Industrieel-ingenieur-KUL/IOT_Project/IOT/IoT.csv

Reference | Qty | Value | DNP | Exclude from BOM | Exclude from Board | Exclude from Simulation | Exclude from Position Files | Footprint | Datasheet
C1,C2,C3,C4,C5,C7,C8,C9,C10,C11,C12,C13,C14,C15,C16 | 15 | 100n |  |  |  |  | ${EXCLUDE_FROM_POS_FILES}
C6 | 1 | 4.7u |  |  |  |  | ${EXCLUDE_FROM_POS_FILES} | RF_Converter:Balun_Johanson_1.6x0.8mm
C17,C19 | 2 | 10nF |  |  |  |  | ${EXCLUDE_FROM_POS_FILES}
C18 | 1 | 47uF/16V |  |  |  |  | ${EXCLUDE_FROM_POS_FILES} | Package_SO:SOIC-8_3.9x4.9mm_P1.27mm
C20 | 1 | 47uF/10V |  |  |  |  | ${EXCLUDE_FROM_POS_FILES} | Package_SO:SOIC-8_3.9x4.9mm_P1.27mm
C21,C22 | 2 | 22uF/50V |  |  |  |  | ${EXCLUDE_FROM_POS_FILES} | Package_SO:SOIC-8_3.9x4.9mm_P1.27mm
D1,D2,D3,D4 | 4 | LED |  |  |  |  | ${EXCLUDE_FROM_POS_FILES} | LED_SMD:LED_Cree-XHP50_3V_HighDensity
D5,D6 | 2 | SK34 |  |  |  |  | ${EXCLUDE_FROM_POS_FILES} | Package_SON:WSON-8-1EP_6x5mm_P1.27mm_EP3.4x4mm
J1 | 1 | Program header |  |  |  |  | ${EXCLUDE_FROM_POS_FILES}
J2 | 1 | Micro_SD_Card_Det2 |  |  |  |  | ${EXCLUDE_FROM_POS_FILES} |  | https://www.hirose.com/en/product/document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
J3 | 1 | USB_C_Receptacle_USB2.0_16P |  |  |  |  | ${EXCLUDE_FROM_POS_FILES} | Connector_USB:USB_C_Receptacle_Amphenol_12401948E412A | https://www.usb.org/sites/default/files/documents/usb_type-c.zip
J4,J5 | 2 | Conn_01x08_Pin |  |  |  |  | ${EXCLUDE_FROM_POS_FILES}
J6 | 1 | RS232_2 |  |  |  |  | ${EXCLUDE_FROM_POS_FILES} | Connector_Dsub:DSUB-9_Pins_Horizontal_P2.77x2.84mm_EdgePinOffset14.56mm_Housed_MountingHolesOffset15.98mm
J7 | 1 | RS232_1 |  |  |  |  | ${EXCLUDE_FROM_POS_FILES} | Connector_Dsub:DSUB-9_Pins_Horizontal_P2.77x2.84mm_EdgePinOffset14.56mm_Housed_MountingHolesOffset15.98mm
J8 | 1 | 24V |  |  |  |  | ${EXCLUDE_FROM_POS_FILES} | TerminalBlock_Philmore:TerminalBlock_Philmore_TB132_1x02_P5.00mm_Horizontal
J9 | 1 | 12V |  |  |  |  | ${EXCLUDE_FROM_POS_FILES} | TerminalBlock_Philmore:TerminalBlock_Philmore_TB132_1x02_P5.00mm_Horizontal
J10 | 1 | 5V |  |  |  |  | ${EXCLUDE_FROM_POS_FILES} | TerminalBlock_Philmore:TerminalBlock_Philmore_TB132_1x02_P5.00mm_Horizontal
J11 | 1 | 3V3 |  |  |  |  | ${EXCLUDE_FROM_POS_FILES} | TerminalBlock_Philmore:TerminalBlock_Philmore_TB132_1x02_P5.00mm_Horizontal
L1 | 1 | 22uH 2A |  |  |  |  | ${EXCLUDE_FROM_POS_FILES}
L2 | 1 | 15uH 3A |  |  |  |  | ${EXCLUDE_FROM_POS_FILES}
R1,R9,R11 | 3 | 10k |  |  |  |  | ${EXCLUDE_FROM_POS_FILES}
R2,R3,R4,R5 | 4 | 1k |  |  |  |  | ${EXCLUDE_FROM_POS_FILES}
R6,R7 | 2 | 5.1k |  |  |  |  | ${EXCLUDE_FROM_POS_FILES}
R8 | 1 | 88.7k |  |  |  |  | ${EXCLUDE_FROM_POS_FILES}
R10 | 1 | 30.9k |  |  |  |  | ${EXCLUDE_FROM_POS_FILES}
SW1,SW2 | 2 | SW_Push |  |  |  |  | ${EXCLUDE_FROM_POS_FILES} | Package_SO:TSSOP-20_4.4x6.5mm_P0.65mm
U1 | 1 | STM32F401RETx |  |  |  |  | ${EXCLUDE_FROM_POS_FILES} | Package_QFP:LQFP-64_10x10mm_P0.5mm | https://www.st.com/resource/en/datasheet/stm32f401re.pdf
U2,U3 | 2 | MAX3232 |  |  |  |  | ${EXCLUDE_FROM_POS_FILES} |  | https://datasheets.maximintegrated.com/en/ds/MAX3222-MAX3241.pdf
U4,U5 | 2 | TPS5430DDA |  |  |  |  | ${EXCLUDE_FROM_POS_FILES} | Package_SO:TI_SO-PowerPAD-8_ThermalVias | http://www.ti.com/lit/ds/symlink/tps5430.pdf
