Industrieel-ingenieur-KUL/IOT_Project/IOT/pdf.pdf

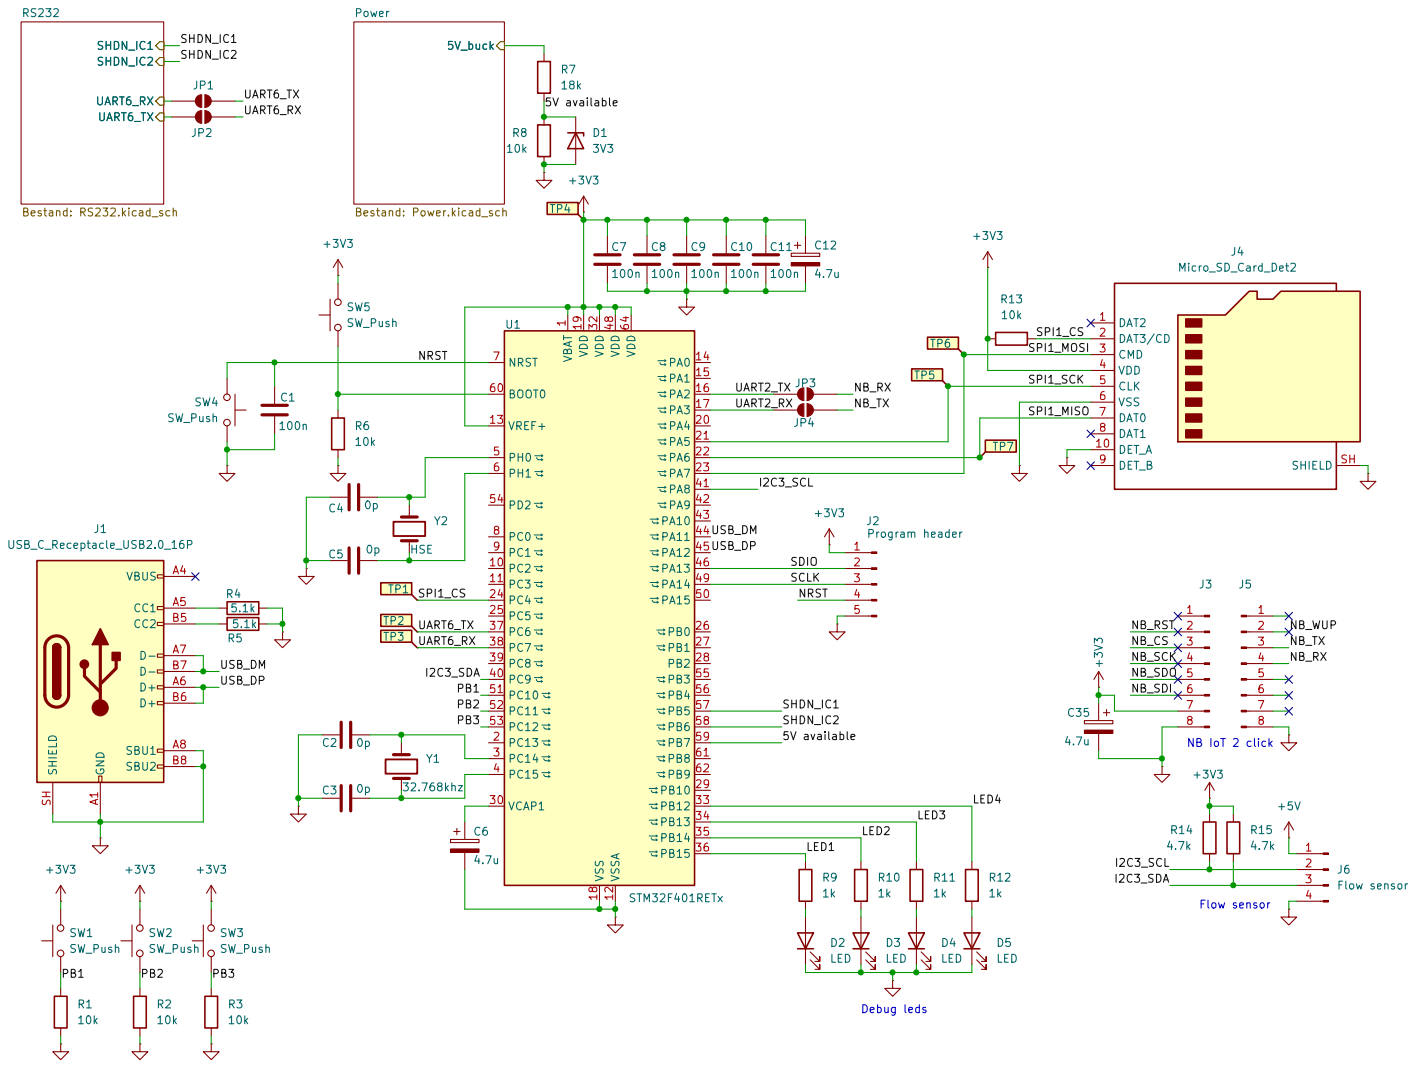
[picture p1: page 1]

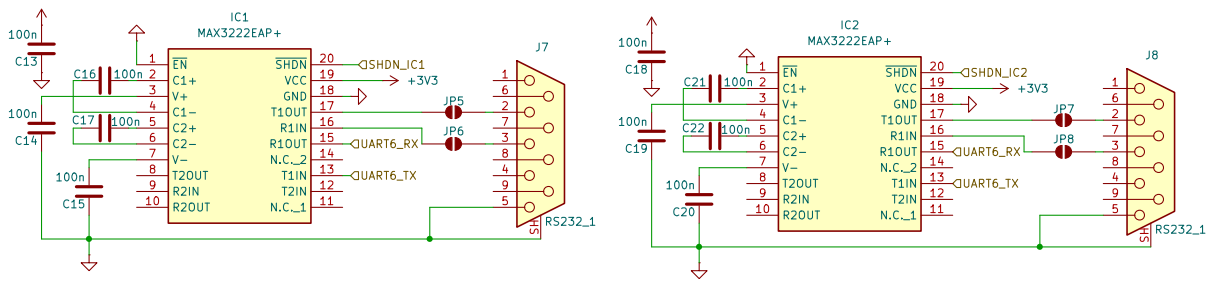
[picture p2: page 2]

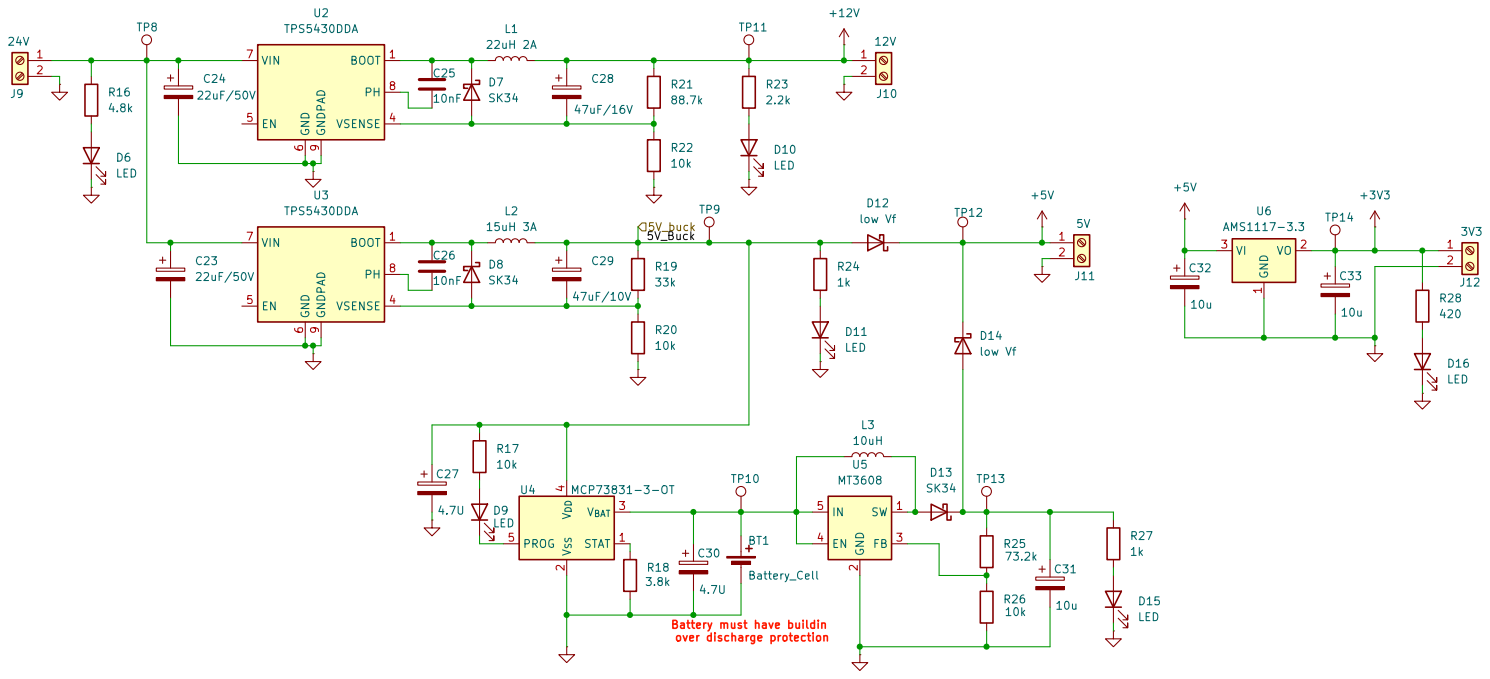
[picture p3: page 3]
