Industrieel-ingenieur-KUL/IOT_Project/IOT/IoT.kicad_pcb

## KiCad design IOT/IoT.kicad_pcb (2026-10-27)

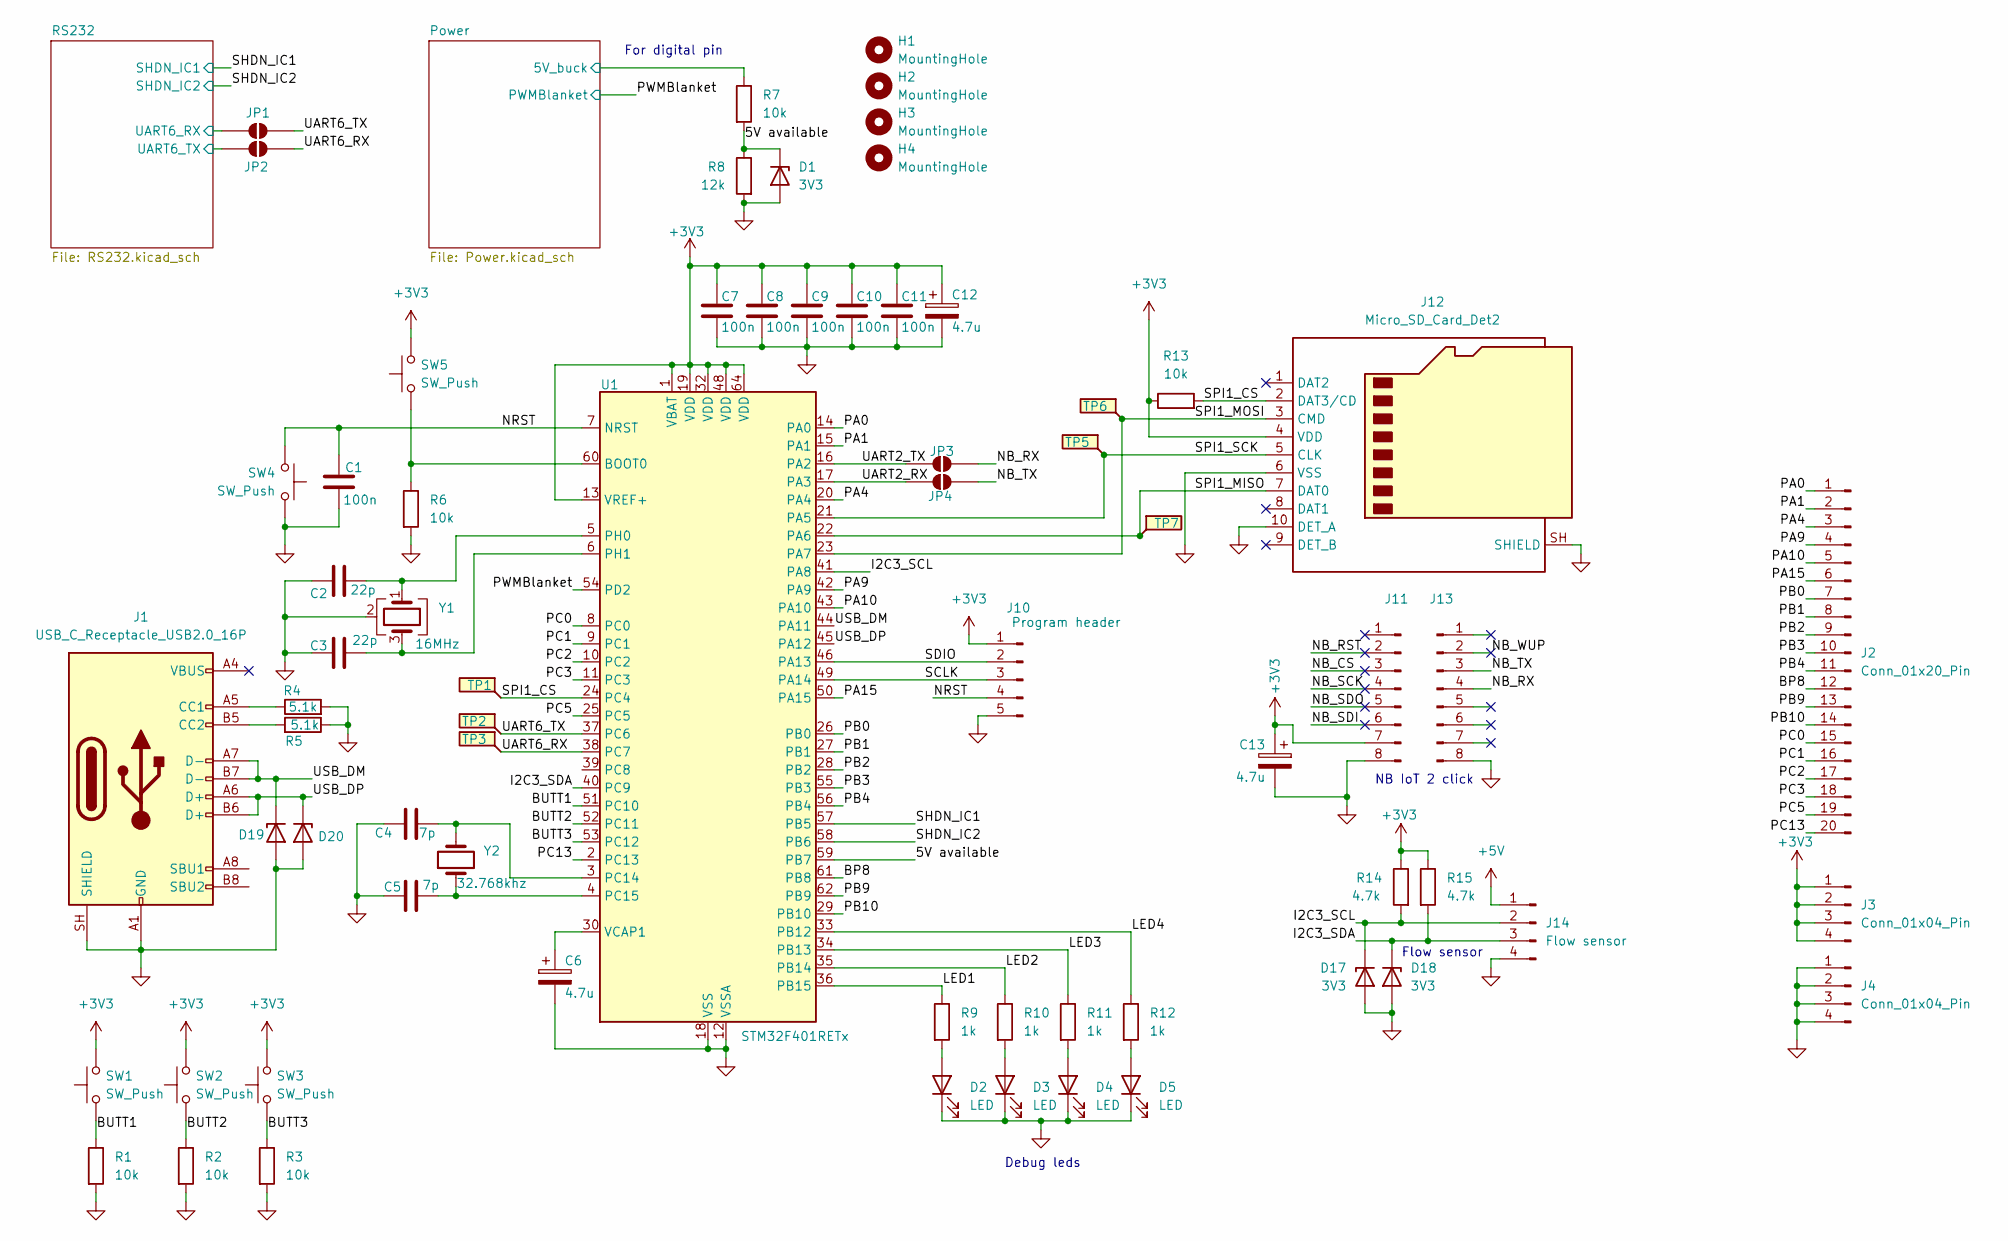
[picture p4: schematic IoT.kicad_sch]

Parts:
C1, C7, C8, C9, C10, C11: 100n; C_0805_2012Metric_Pad1.18x1.45mm_HandSolder
C2, C3: 22p; C_0805_2012Metric_Pad1.18x1.45mm_HandSolder
C4, C5: 7p; C_0805_2012Metric_Pad1.18x1.45mm_HandSolder
C6, C12, C13: 4.7u; C_0805_2012Metric_Pad1.18x1.45mm_HandSolder
D1, D17, D18: 3V3; Nexperia_CFP3_SOD-123W
D2, D3, D4, D5: LED; D_0805_2012Metric_Pad1.15x1.40mm_HandSolder
D19, D20: PTVS5V0Z1USK; D_1206_3216Metric_Pad1.42x1.75mm_HandSolder
H1, H2, H3, H4: MountingHole; MountingHole_5.3mm_M5_ISO14580
J1: USB_C_Receptacle_USB2.0_16P; USB_C_Receptacle_G-Switch_GT-USB-7010ASV
J2: Conn_01x20_Pin; PinHeader_1x20_P2.54mm_Vertical
J3, J4: Conn_01x04_Pin; PinSocket_1x04_P2.54mm_Vertical
J10: Program header; PinSocket_1x05_P2.54mm_Vertical
J11, J13: Conn_01x08_Pin; PinSocket_1x08_P2.54mm_Vertical
J12: Micro_SD_Card_Det2; microSD_HC_Molex_104031-0811
J14: Flow sensor; PinSocket_1x04_P2.54mm_Vertical
JP1, JP2, JP3, JP4: SolderJumper_2_Open; SolderJumper-2_P1.3mm_Open_RoundedPad1.0x1.5mm
R1, R2, R3, R6, R7, R13: 10k; LED_1206_3216Metric_Pad1.42x1.75mm_HandSolder
R4, R5: 5.1k; LED_1206_3216Metric_Pad1.42x1.75mm_HandSolder
R8: 12k; LED_1206_3216Metric_Pad1.42x1.75mm_HandSolder
R9, R10, R11, R12: 1k; LED_1206_3216Metric_Pad1.42x1.75mm_HandSolder
R14, R15: 4.7k; LED_1206_3216Metric_Pad1.42x1.75mm_HandSolder
SW1, SW2, SW3, SW4, SW5: SW_Push; SW_DIP_SPSTx01_Slide_6.7x4.1mm_W6.73mm_P2.54mm_LowProfile_J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
TP1, TP2, TP3, TP5, TP6, TP7: TestPoint_Flag; Pin_D0.7mm_L6.5mm_W1.8mm_FlatFork
U1: STM32F401RETx; LQFP-64_10x10mm_P0.5mm
Y1: 16MHz; Crystal_SMD_Abracon_ABM8AIG-4Pin_3.2x2.5mm
Y2: 32.768khz; Crystal_SMD_3215-2Pin_3.2x1.5mm

Connections:
+3V3: C7.1, C8.1, C9.1, C10.1, C11.1, C12.1, C13.1, J3.1, J3.2, J3.3, J3.4, J10.1, J11.7, J12.4 (VDD), R13.1, R14.1, R15.1, SW1.2, SW2.2, SW3.2, SW5.2, U1.1 (VBAT), U1.13 (VREF+), U1.19 (VDD), U1.32 (VDD), U1.48 (VDD), U1.64 (VDD); also elsewhere on the board
+5V: J14.1; also elsewhere on the board
/5V available: D1.1 (K), R7.2, R8.1, U1.59 (PB7)
/BP8: J2.12, U1.61 (PB8)
/BUTT1: R1.1, SW1.1, U1.51 (PC10)
/BUTT2: R2.1, SW2.1, U1.52 (PC11)
/BUTT3: R3.1, SW3.1, U1.53 (PC12)
/I2C3_SCL: D17.1 (K), J14.2, R14.2, U1.41 (PA8)
/I2C3_SDA: D18.1 (K), J14.3, R15.2, U1.40 (PC9)
/LED1: R9.1, U1.36 (PB15)
/LED2: R10.1, U1.35 (PB14)
/LED3: R11.1, U1.34 (PB13)
/LED4: R12.1, U1.33 (PB12)
/NB_CS: J11.3
/NB_RST: J11.2
/NB_RX: J13.4, JP3.2 (B)
/NB_SCK: J11.4
/NB_SDI: J11.6
/NB_SDO: J11.5
/NB_TX: J13.3, JP4.2 (B)
/NB_WUP: J13.2
/NRST: C1.1, J10.4, SW4.2, U1.7 (NRST)
/PA0: J2.1, U1.14 (PA0)
/PA1: J2.2, U1.15 (PA1)
/PA4: J2.3, U1.20 (PA4)
/PA9: J2.4, U1.42 (PA9)
/PA10: J2.5, U1.43 (PA10)
/PA15: J2.6, U1.50 (PA15)
/PB0: J2.7, U1.26 (PB0)
/PB1: J2.8, U1.27 (PB1)
/PB2: J2.9, U1.28 (PB2)
/PB3: J2.10, U1.55 (PB3)
/PB4: J2.11, U1.56 (PB4)
/PB9: J2.13, U1.62 (PB9)
/PB10: J2.14, U1.29 (PB10)
/PC0: J2.15, U1.8 (PC0)
/PC1: J2.16, U1.9 (PC1)
/PC2: J2.17, U1.10 (PC2)
/PC3: J2.18, U1.11 (PC3)
/PC5: J2.19, U1.25 (PC5)
/PC13: J2.20, U1.2 (PC13)
/PWMBlanket: U1.54 (PD2); also elsewhere on the board
/Power/5V_Buck: R7.1; also elsewhere on the board
/RS232/UART6_RX: JP1.1 (A); also elsewhere on the board
/RS232/UART6_TX: JP2.1 (A); also elsewhere on the board
/SCLK: J10.3, U1.49 (PA14)
/SDIO: J10.2, U1.46 (PA13)
/SHDN_IC1: U1.57 (PB5); also elsewhere on the board
/SHDN_IC2: U1.58 (PB6); also elsewhere on the board
/SPI1_CS: J12.2 (DAT3/CD), R13.2, TP1.1 (1_1), U1.24 (PC4)
/SPI1_MISO: J12.7 (DAT0), TP7.1 (1_1), U1.22 (PA6)
/SPI1_MOSI: J12.3 (CMD), TP6.1 (1_1), U1.23 (PA7)
/SPI1_SCK: J12.5 (CLK), TP5.1 (1_1), U1.21 (PA5)
/UART2_RX: JP4.1 (A), U1.17 (PA3)
/UART2_TX: JP3.1 (A), U1.16 (PA2)
/UART6_RX: JP2.2 (B), TP3.1 (1_1), U1.38 (PC7)
/UART6_TX: JP1.2 (B), TP2.1 (1_1), U1.37 (PC6)
/USB_DM: D19.1 (K), J1.A7 (D-), J1.B7 (D-), U1.44 (PA11)
/USB_DP: D20.1 (K), J1.A6 (D+), J1.B6 (D+), U1.45 (PA12)
GND: C1.2, C2.1, C3.1, C4.1, C5.1, C6.2, C7.2, C8.2, C9.2, C10.2, C11.2, C12.2, C13.2, D1.2 (A), D2.1 (K), D3.1 (K), D4.1 (K), D5.1 (K), D17.2 (A), D18.2 (A), D19.2 (A), D20.2 (A), J1.A1 (GND), J1.A12 (GND), J1.B1 (GND), J1.B12 (GND), J1.SH (SHIELD), J4.1, J4.2, J4.3, J4.4, J10.5, J11.8, J12.6 (VSS), J12.10 (DET_A), J12.SH (SHIELD), J13.8, J14.4, R1.2, R2.2, R3.2, R4.2, R5.1, R6.2, R8.2, SW4.1, U1.12 (VSSA), U1.18 (VSS), U1.31 (VSS), U1.47 (VSS), U1.63 (VSS), Y1.2 (G), Y1.4 (G); also elsewhere on the board
unnamed: D2.2 (A), R9.2
unnamed: D3.2 (A), R10.2
unnamed: D4.2 (A), R11.2
unnamed: D5.2 (A), R12.2
unnamed: J1.A5 (CC1), R4.1
unnamed: J1.B5 (CC2), R5.2
unnamed: R6.1, SW5.1, U1.60 (BOOT0)
unnamed: C4.2, U1.3 (PC14), Y2.2
unnamed: C5.2, U1.4 (PC15), Y2.1
unnamed: C2.2, U1.5 (PH0), Y1.1
unnamed: C3.2, U1.6 (PH1), Y1.3
unnamed: C6.1, U1.30 (VCAP1)

Notes on the sheet:
Debug leds
For digital pin
Flow sensor
NB IoT 2 click

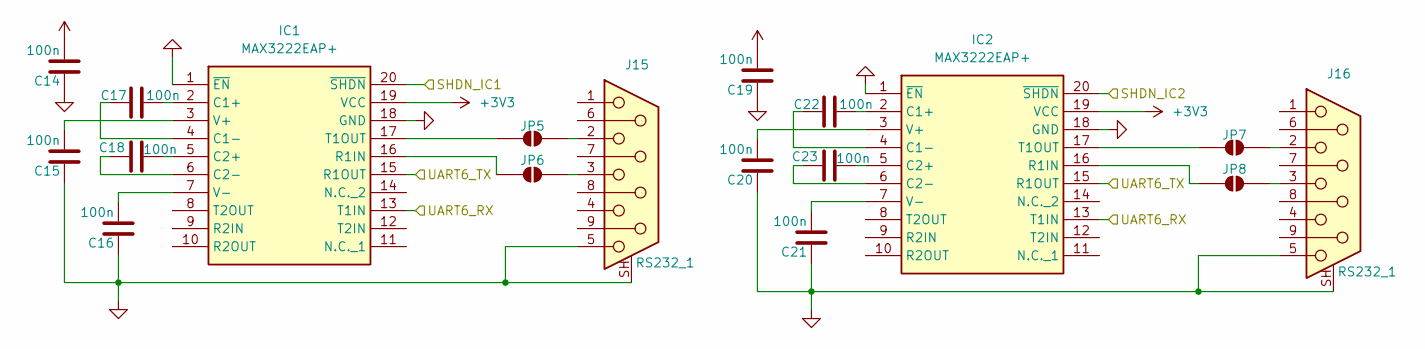
[picture p5: schematic RS232.kicad_sch]

Parts:
C14, C15, C16, C17, C18, C19, C20, C21, C22, C23: 100n; C_0805_2012Metric_Pad1.18x1.45mm_HandSolder
IC1, IC2: MAX3222EAP+; TSSOP-20_4.4x5mm_P0.4mm; Mouser Part Number 700-MAX3222EAP
J15, J16: RS232_1; DSUB-9_Pins_Horizontal_P2.77x2.84mm_EdgePinOffset14.56mm_Ho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
JP5, JP6, JP7, JP8: SolderJumper_2_Open; SolderJumper-2_P1.3mm_Open_RoundedPad1.0x1.5mm

Connections:
+3V3: C14.2, C19.2, IC1.19 (VCC), IC2.19 (VCC); also elsewhere on the board
/RS232/UART6_RX: IC1.13 (T1IN), IC2.13 (T1IN); also elsewhere on the board
/RS232/UART6_TX: IC1.15 (R1OUT), IC2.15 (R1OUT); also elsewhere on the board
/SHDN_IC1: IC1.20 (~SHDN); also elsewhere on the board
/SHDN_IC2: IC2.20 (~SHDN); also elsewhere on the board
GND: C14.1, C15.1, C16.1, C19.1, C20.1, C21.1, IC1.1 (~EN), IC1.18 (GND), IC2.1 (~EN), IC2.18 (GND), J15.5, J15.SH (PAD), J16.5, J16.SH (PAD); also elsewhere on the board
unnamed: C17.2, IC1.2 (C1+)
unnamed: C17.1, IC1.4 (C1-)
unnamed: C18.2, IC1.5 (C2+)
unnamed: C18.1, IC1.6 (C2-)
unnamed: IC1.16 (R1IN), JP6.1 (A)
unnamed: IC1.17 (T1OUT), JP5.1 (A)
unnamed: C15.2, IC1.3 (V+)
unnamed: C16.2, IC1.7 (V-)
unnamed: C22.2, IC2.2 (C1+)
unnamed: C22.1, IC2.4 (C1-)
unnamed: C23.2, IC2.5 (C2+)
unnamed: C23.1, IC2.6 (C2-)
unnamed: IC2.16 (R1IN), JP8.1 (A)
unnamed: IC2.17 (T1OUT), JP7.1 (A)
unnamed: C20.2, IC2.3 (V+)
unnamed: C21.2, IC2.7 (V-)
unnamed: J15.2, JP5.2 (B)
unnamed: J15.3, JP6.2 (B)
unnamed: J16.2, JP7.2 (B)
unnamed: J16.3, JP8.2 (B)

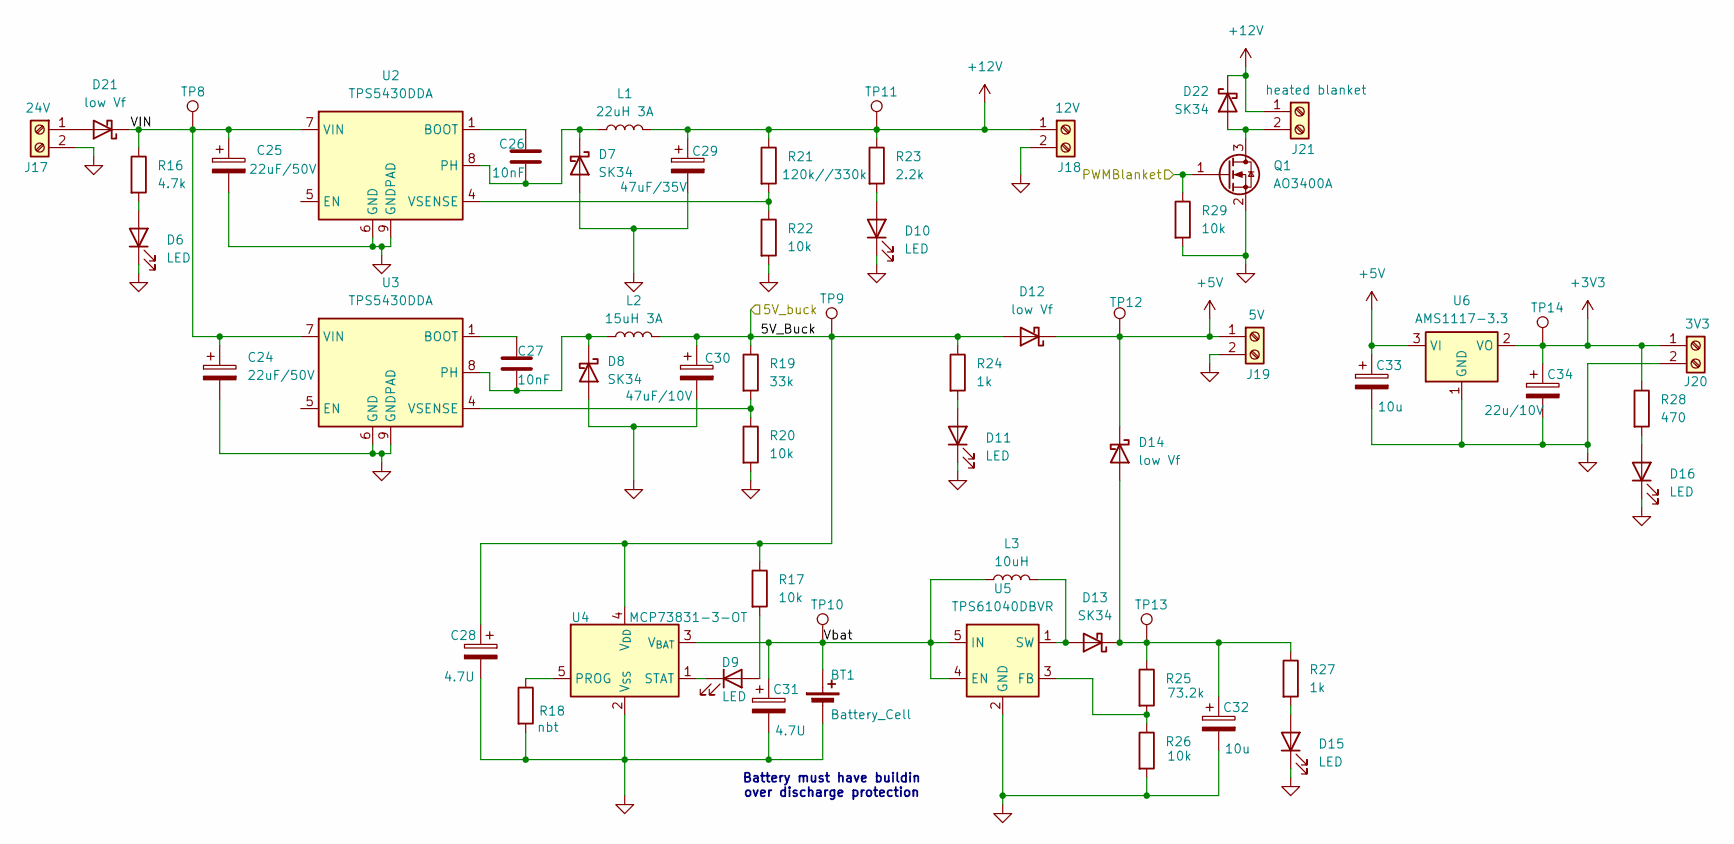
[picture p6: schematic Power.kicad_sch]

Parts:
BT1: Battery_Cell; BatteryHolder_MPD_BH-18650-PC
C24, C25: 22uF/50V; CP_Elec_5x5.4
C26, C27: 10nF; C_0805_2012Metric_Pad1.18x1.45mm_HandSolder
C28, C31: 4.7U; CP_Elec_4x5.4
C29: 47uF/35V; CP_Elec_8x10
C30: 47uF/10V; CP_Elec_8x10
C32, C33: 10u; C_0805_2012Metric_Pad1.18x1.45mm_HandSolder
C34: 22u/10V; CP_EIA-3528-12_Kemet-T_HandSolder
D6, D9, D10, D11, D15, D16: LED; D_0805_2012Metric_Pad1.15x1.40mm_HandSolder
D7, D8, D13, D22: SK34; D_SMA_Handsoldering
D12, D14, D21: low Vf; D_SMC_Handsoldering
J17: 24V; TerminalBlock_Philmore_TB132_1x02_P5.00mm_Horizontal
J18: 12V; TerminalBlock_Philmore_TB132_1x02_P5.00mm_Horizontal
J19: 5V; TerminalBlock_Philmore_TB132_1x02_P5.00mm_Horizontal
J20: 3V3; TerminalBlock_Philmore_TB132_1x02_P5.00mm_Horizontal
J21: heated blanket; TerminalBlock_Philmore_TB132_1x02_P5.00mm_Horizontal
L1: 22uH 3A; L_Wuerth_WE-PD-Typ-LS_Handsoldering
L2: 15uH 3A; L_Bourns_SRP7028A_7.3x6.6mm
L3: 10uH; L_Bourns_SRP7028A_7.3x6.6mm
Q1: AO3400A; SOT-23
R16: 4.7k; LED_1206_3216Metric_Pad1.42x1.75mm_HandSolder
R17, R20, R22, R26, R29: 10k; LED_1206_3216Metric_Pad1.42x1.75mm_HandSolder
R18: nbt; LED_1206_3216Metric_Pad1.42x1.75mm_HandSolder
R19: 33k; LED_1206_3216Metric_Pad1.42x1.75mm_HandSolder
R21: 120k//330k; LED_1206_3216Metric_Pad1.42x1.75mm_HandSolder
R23: 2.2k; LED_1206_3216Metric_Pad1.42x1.75mm_HandSolder
R24, R27: 1k; LED_1206_3216Metric_Pad1.42x1.75mm_HandSolder
R25: 73.2k; LED_1206_3216Metric_Pad1.42x1.75mm_HandSolder
R28: 470; LED_1206_3216Metric_Pad1.42x1.75mm_HandSolder
TP8, TP9, TP10, TP11, TP12, TP13, TP14: TestPoint; Pin_D0.7mm_L6.5mm_W1.8mm_FlatFork
U2, U3: TPS5430DDA; TI_SO-PowerPAD-8_ThermalVias
U4: MCP73831-3-OT; SOT-23-5
U5: TPS61040DBVR; SOT-23-6
U6: AMS1117-3.3; SOT-223-3_TabPin2

Connections:
+3V3: C34.1, J20.1, R28.1, TP14.1 (1_1), U6.2 (VO); also elsewhere on the board
+5V: C33.1, D12.1 (K), D14.1 (K), J19.1, TP12.1 (1_1), U6.3 (VI); also elsewhere on the board
+12V: C29.1, D22.1 (K), J18.1, J21.1, L1.2, R21.1, R23.1, TP11.1 (1_1)
/PWMBlanket: Q1.1 (G), R29.1; also elsewhere on the board
/Power/5V_Buck: C28.1, C30.1, D12.2 (A), L2.2, R17.1, R19.1, R24.1, TP9.1 (1_1), U4.4 (V_{DD}); also elsewhere on the board
/Power/VIN: C24.1, C25.1, D21.1 (K), R16.1, TP8.1 (1_1), U2.7 (VIN), U3.7 (VIN)
/Power/Vbat: BT1.1 (+), C31.1, L3.1, TP10.1 (1_1), U4.3 (V_{BAT}), U5.4 (EN), U5.5 (IN)
GND: BT1.2 (-), C24.2, C25.2, C28.2, C29.2, C30.2, C31.2, C32.2, C33.2, C34.2, D6.1 (K), D7.2 (A), D8.2 (A), D10.1 (K), D11.1 (K), D15.1 (K), D16.1 (K), J17.2, J18.2, J19.2, J20.2, Q1.2 (S), R18.2, R20.2, R22.2, R26.2, R29.2, U2.6 (GND), U2.9 (GNDPAD), U3.6 (GND), U3.9 (GNDPAD), U4.2 (V_{SS}), U5.2 (GND), U6.1 (GND); also elsewhere on the board
unnamed: D6.2 (A), R16.2
unnamed: C26.2, D7.1 (K), L1.1, U2.8 (PH)
unnamed: C27.2, D8.1 (K), L2.1, U3.8 (PH)
unnamed: D9.2 (A), R17.2
unnamed: D9.1 (K), U4.1 (STAT)
unnamed: D10.2 (A), R23.2
unnamed: D11.2 (A), R24.2
unnamed: D13.2 (A), L3.2, U5.1 (SW)
unnamed: C32.1, D13.1 (K), D14.2 (A), R25.1, R27.1, TP13.1 (1_1)
unnamed: D15.2 (A), R27.2
unnamed: D16.2 (A), R28.2
unnamed: D21.2 (A), J17.1
unnamed: D22.2 (A), J21.2, Q1.3 (D)
unnamed: C26.1, U2.1 (BOOT)
unnamed: R21.2, R22.1, U2.4 (VSENSE)
unnamed: C27.1, U3.1 (BOOT)
unnamed: R19.2, R20.1, U3.4 (VSENSE)
unnamed: R18.1, U4.5 (PROG)
unnamed: R25.2, R26.1, U5.3 (FB)

Notes on the sheet:
Battery must have buildin over discharge protection

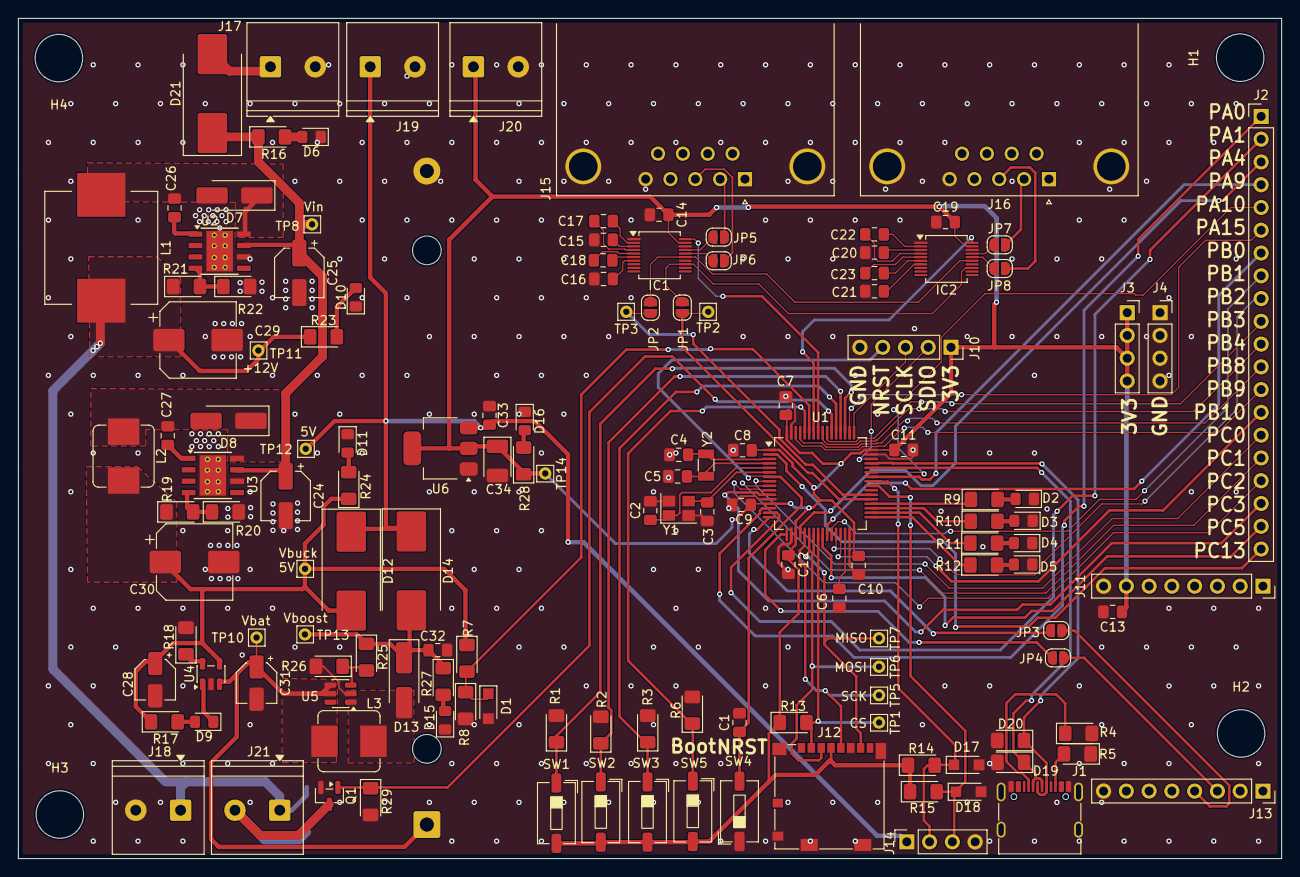
[picture p7: board IoT.kicad_pcb from above]

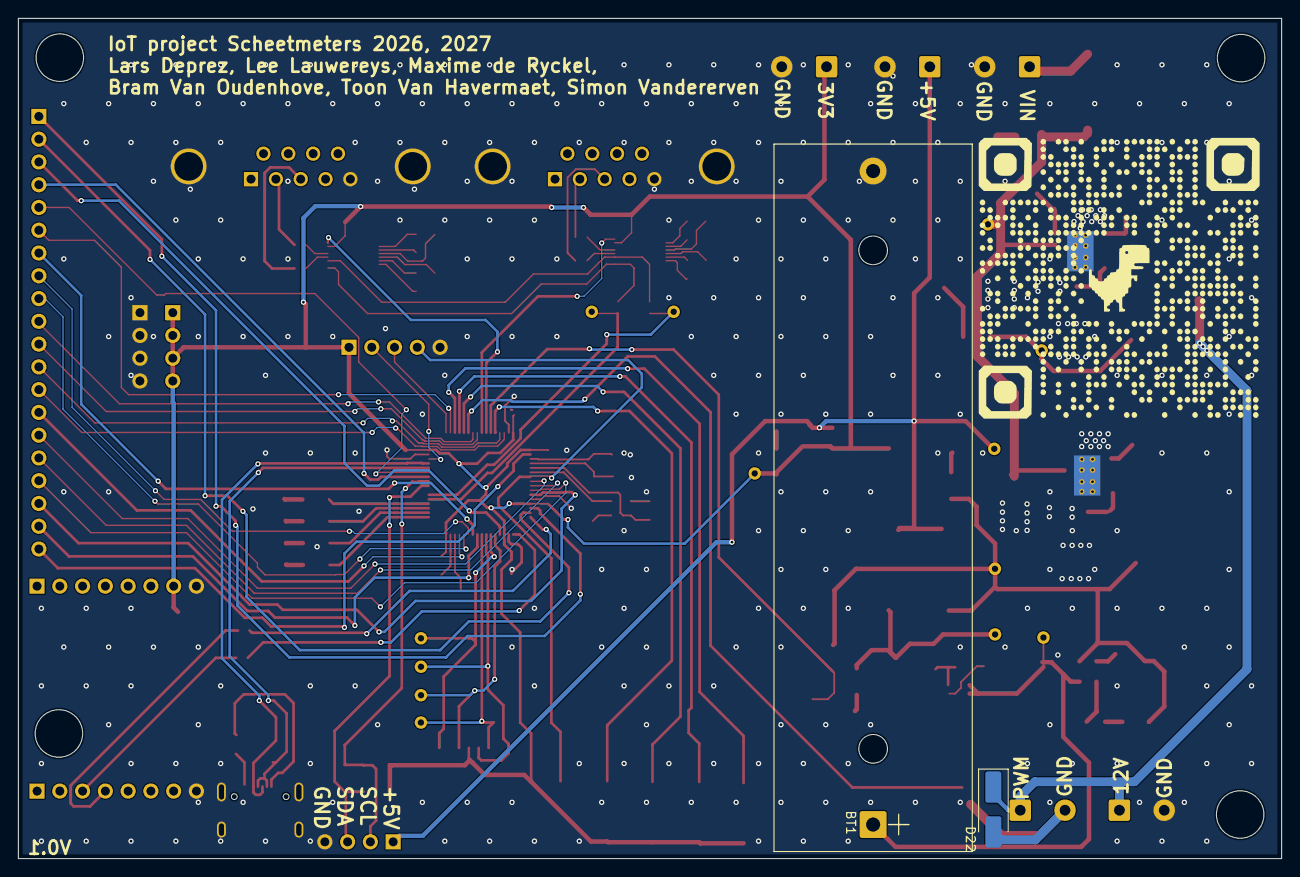
[picture p8: board IoT.kicad_pcb from below]

Board: 2 copper layers, 140.9 x 93.7 mm, 146 parts (2 on the bottom side), 108 nets.
