Industrieel-ingenieur-KUL/IOT_Project/STMCUBE/STMCUBE.ioc

Mcu.UserName=STM32F401RETx
PA11.Signal=USB_OTG_FS_DM
PA12.Signal=USB_OTG_FS_DP
PA13.Signal=SYS_JTMS-SWDIO
PA14.Signal=SYS_JTCK-SWCLK
PA2.Signal=USART2_TX
PA3.Signal=USART2_RX
PA5.Signal=SPI1_SCK
PA6.Signal=SPI1_MISO
PA7.Signal=SPI1_MOSI
PA8.Signal=I2C3_SCL
PB12.GPIO_Label=LED4
PB12.Signal=GPIO_Output
PB13.GPIO_Label=LED3
PB13.Signal=GPIO_Output
PB14.GPIO_Label=LED2
PB14.Signal=GPIO_Output
PB5.GPIO_Label=SHDN_IC1
PB5.Signal=GPIO_Output
PB6.GPIO_Label=SHDN_IC2
PB6.Signal=GPIO_Output
PB7.GPIO_Label=V5V_available
PB7.Signal=GPIO_Input
PC10.GPIO_Label=BP1
PC10.Signal=GPIO_Input
PC11.GPIO_Label=PB2
PC11.Signal=GPIO_Input
PC12.GPIO_Label=PB3
PC12.Signal=GPIO_Input
PC14-OSC32_IN.Signal=RCC_OSC32_IN
PC15-OSC32_OUT.Signal=RCC_OSC32_OUT
PC4.GPIO_Label=SPI1_CS
PC4.Signal=GPIO_Output
PC6.Signal=USART6_TX
PC7.Signal=USART6_RX
PC8.GPIO_Label=LED1
PC8.Signal=GPIO_Output
PC9.Signal=I2C3_SDA
