Industrieel-ingenieur-KUL/IOT_Project/(commit log)

2026-10-22 started pcb
    [IoT.kicad_pcb, IoT.kicad_sch, Power.kicad_sch, RS232.kicad_sch]
2026-10-22 update pcb with outline and tighter placemetn
    [IoT.kicad_pcb]
2026-10-23 routed full pcb
    [IoT.kicad_pcb, IoT.kicad_sch, Power.kicad_sch]
2026-10-24 added silkscreen and updated footprints
    [IoT-B_Cu.gbr, IoT-B_Mask.gbr, IoT-B_Paste.gbr, IoT-B_Silkscreen.gbr, IoT-Edge_Cuts.gbr, IoT-F_Cu.gbr, IoT-F_Mask.gbr, IoT-F_Paste.gbr]
2026-10-26 update PCB and schematic with components we can order
    [IoT.kicad_pcb, Power.kicad_sch]
2026-10-27 checked DRC and generated gerber files
    [IoT-B_Cu.gbr, IoT-B_Mask.gbr, IoT-B_Paste.gbr, IoT-B_Silkscreen.gbr, IoT-Edge_Cuts.gbr, IoT-F_Cu.gbr, IoT-F_Mask.gbr, IoT-F_Paste.gbr]
